KitKatFarrelly/LIDAR-Project-Hardware/README.md

# What is this??
This is the KiCAD files for the PCB and schematic of several iterations of my LIDAR sensor board.
The goal of this board is a wifi-enabled LIDAR sensor that also collects direction and acceleration data via IMU and can act as a flight controller.
