KitKatFarrelly/LIDAR-Project-Hardware/EPC611 LIDAR revision/Microlidar BOM For PCBWay.xlsx

Line Item | Component Type | Part | Manufacturer | Manufacturer PN | References | Quantity | Footprint | Type | Tolerance | Wattage | Voltage Rating | Generic OK? | Notes
1 | Capacitor | 1u Cap | Samsung | CL10B105KA8NNNC | C1,C7,C11,C17,C25 | 5 | 0603 | SMD |  |  | 25V | Yes
2 | Capacitor | 4.7u Cap | Murata | GRM188R61E475KE11D | C2,C3,C9,C10,C12,C14 | 6 | 0603 | SMD |  |  | 35V | Yes
3 | Capacitor | 10u Cap | Samsung | CL21X106KAYNNNE | C4,C33 | 2 | 0805 | SMD |  |  | 25V | Yes
4 | Capacitor | 100n Cap | Samsung | CL05B104KA5NNNC | C5,C6,C8,C18,C19,C20,C21,C22,C23,C24,C26,C27,C30,C31,C32,C35 | 16 | 0402 | SMD |  |  | 25V | Yes
5 | Capacitor | 166p Cap | Murata | GCM1555C1H161FA16D | C13 | 1 | 0402 | SMD |  |  | 50V | Yes
6 | Capacitor | 26p Cap | AVX Corporation | 04025A270JAT2A | C15 | 1 | 0402 | SMD |  |  | 50V | Yes
7 | Capacitor | 22u Cap | YAGEO | CC0805MKX5R8BB226 | C16 | 1 | 0805 | SMD |  |  | 25V | Yes
8 | Capacitor | 6p Cap | Samsung | CL05C060DB5NNNC | C28,C29 | 2 | 0402 | SMD |  |  | 50V | Yes
9 | Capacitor | 220n Cap | Murata | GRM155C8YA224KE01D | C34 | 1 | 0402 | SMD |  |  | 25V | Yes
10 | Diode | Schottky | Micro Commercial Co | BAS40-TP | D1,D2,D3 | 3 | SOT-23 | SMD
11 | Diode | LED | OSRAM | SFH 4718A | D4,D5 | 2 | 3-SMD | SMD
12 | Diode | Schottky | SMC Diode Solutions | DSS14UTR | D6 | 1 | SOD-123F | SMD
13 | Inductor | 33u Ind | Taiyo Yuden | CB2518T330K | L1 | 1 | 1008 | SMD
14 | Inductor | 1u Ind | TDK Corporation | MLZ1608A1R0WT000 | L2 | 1 | 0603 | SMD
15 | Connector | 4 pin Molex | Molex | 53261-0471 | J1,J2 | 2 | SMT 4P | SMD |  |  |  |  | DNP
16 | Connector | Micro B USB | Molex | 105017-0001 | J3 | 1 | MICRO B USB | SMD |  |  | 30V
17 | Connector | 8 pin Molex | Molex | 53261-0871 | J5 | 1 | SMT 8P | SMD |  |  |  |  | DNP
18 | Connector | 2 pin header | GCT | BC020-02-A-0200-0300-L-G | J6 | 1 | THRU 2P | Through Hole |  |  | 250V
19 | Transistor | NMOSFET | Nexperia USA Inc. | 2N7002P,215 | Q1 | 1 | SOT-23 | SMD
20 | Resistor | 1 Res | Stackpole Electronics | RNCP0805FTD1R00 | R1 | 1 | 0805 | SMD | 1% | 1/4 W |  | Yes
21 | Resistor | 3.3k Res | Panasonic | ERJ-2GEJ332X | R2 | 1 | 0402 | SMD | 1% | 1/10 W |  | Yes
22 | Resistor | 1k Res | YAGEO | RC0402FR-7W1KL | R3,R6,R8,R10,R18,R19 | 6 | 0402 | SMD | 1% | 1/8 W |  | Yes
23 | Resistor | 10k Res | YAGEO | AC0402FR-7W10KL | R4,R5,R15,R22 | 4 | 0402 | SMD | 1% | 1/8 W |  | Yes
24 | Resistor | 75k Res | Stackpole Electronics | RMCF0402FT75K0 | R7 | 1 | 0402 | SMD | 1% | 1/16 W |  | Yes
25 | Resistor | 82.5k Res | Samsung | RC1005F8252CS | R9 | 1 | 0402 | SMD | 1% | 1/16 W |  | Yes
26 | Resistor | 1.2k Res | Panasonic | ERJ-U02F1201X | R11 | 1 | 0402 | SMD | 1% | 1/10 W |  | Yes
27 | Resistor | 49.9 Res | YAGEO | AF0402FR-0749R9L | R12,R13,R14 | 3 | 0402 | SMD | 1% | 1/16 W |  | Yes
28 | Resistor | 27.4 Res | Panasonic | ERJ-2RKF27R4X | R16, R17 | 2 | 0402 | SMD | 1% | 1/16 W |  | Yes
29 | Resistor | Jumper | YAGEO | RC0805JR-070RL | R20 | 1 | 0805 | SMD | 1% | 1/10 W |  | Yes | DNP
30 | Resistor | 100k Res | YAGEO | RC0201JR-07100KL | R21 | 1 | 0201 | SMD | 1% | 1/20 W |  | Yes
31 | Integrated Circuit | Regulator | RICOH | R1283K001C | U1 | 1 | 12-UFDFN | SMD
32 | Integrated Circuit | LIDAR | ESPROS | EPC611 | U2 | 1 | 24-CSP | SMD
33 | Integrated Circuit | RP2040 | Raspberry Pi | SC0908(7) | U3 | 1 | 56-VFQFN | SMD
34 | Integrated Circuit | Flash | Winbond | W25Q32JVZPIQ | U4 | 1 | 8-WDFN | SMD
35 | Integrated Circuit | Regulator | Texas Instruments | TPSM828214SILR | U5 | 1 | 10-uSIP | SMD
36 | Integrated Circuit | IMU | STMicroelectronics | LSM303AGRTR | U6 | 1 | 12-VFLGA | SMD
37 | Oscillator | 4MHz | ECS Inc. | ECS-2333-040-BN-TR | Y1 | 1 | 4-SMD | SMD
38 | Oscillator | 12MHz | ECS Inc. | ECS-120-8-36B-CWY-TR | Y2 | 1 | 4-SMD | SMD
 | Generic OK: For Generic Components, the Footprint and Value must match. The Wattage or Voltage rating must match or be better than specified.
