KitKatFarrelly/LIDAR-Project-Hardware/EPC611 LIDAR revision/Microlidar BOM.xlsx

Component Type | Part | Manufacturer PN | References | Footprint | Wattage | Voltage Rating | Cost x1 | Cost x10 | Number Used | Cost per board for 1 board | Cost per board for 10 boards | Generic OK?
Capacitor | 1u Cap |  | C1,C7,C11,C17,C25 | 0603 |  | 16V | 0.1 | 0.035 | 5 | 0.5 | 0.175 | Yes
Capacitor | 4.7u Cap |  | C2,C3,C9,C10,C12,C14 | 0603 |  | 16V | 0.11 | 0.081 | 6 | 0.66 | 0.486 | Yes
Capacitor | 10u Cap |  | C4,C33 | 0805 |  | 16V | 0.11 | 0.083 | 2 | 0.22 | 0.166 | Yes
Capacitor | 100n Cap |  | C5,C6,C8,C18,C19,C20,C21,C22,C23,C24,C26,C27,C30,C31,C32,C35 | 0402 |  | 16V | 0.1 | 0.019 | 16 | 1.6 | 0.304 | Yes
Capacitor | 166p Cap |  | C13 | 0402 |  | 16V | 0.1 | 0.044 | 1 | 0.1 | 0.044 | Yes
Capacitor | 26p Cap |  | C15 | 0402 |  | 16V | 0.1 | 0.035 | 1 | 0.1 | 0.035 | Yes
Capacitor | 22u Cap |  | C16 | 0805 |  | 16V | 0.34 | 0.235 | 1 | 0.34 | 0.235 | Yes
Capacitor | 6p Cap |  | C28,C29 | 0402 |  | 16V | 0.1 | 0.038 | 2 | 0.2 | 0.076 | Yes
Capacitor | 220n Cap |  | C34 | 0402 |  | 16V | 0.14 | 0.101 | 1 | 0.14 | 0.101 | Yes
Diode | Schottky | BAS40-TP | D1,D2,D3 | SOT-23 |  |  | 0.24 | 0.162 | 3 | 0.72 | 0.486
Diode | LED | SFH 4718A | D4,D5 |  |  |  | 2.23 | 1.487 | 2 | 4.46 | 2.974
Diode | Schottky | DSS14UTR | D6 | SOD-123F |  |  | 0.23 | 0.189 | 1 | 0.23 | 0.189
Inductor | 33u Ind | CB2518T330K | L1 | 1008 |  |  | 0.17 | 0.152 | 1 | 0.17 | 0.152
Inductor | 1u Ind | MLZ1608A1R0WT000 | L2 | 0603 |  |  | 0.15 | 0.135 | 1 | 0.15 | 0.135
Connector | 4 pin Molex | 53261-0471 | J1,J2 |  |  |  | 0.59 | 0.499 | 2 | 1.18 | 0.998
Connector | Micro B USB | 105017-0001 | J3 |  |  | 30V | 0.96 | 0.794 | 1 | 0.96 | 0.794
Connector | 8 pin Molex | 53261-0871 | J5 |  |  |  | 0.76 | 0.631 | 1 | 0.76 | 0.631
Connector | 2 pin header | BC020-02-A-0200-0300-L-G | J6 |  |  | 250V | 0.5 | 0.427 | 1 | 0.5 | 0.427
Transistor | NMOSFET | 2N7002P,215 | Q1 | SOT-23 |  |  | 0.17 | 0.117 | 1 | 0.17 | 0.117
Resistor | 1 Res |  | R1 | 0805 | 1/4 W |  | 0.1 | 0.073 | 1 | 0.1 | 0.073 | Yes
Resistor | 3.3k Res |  | R2 | 0402 | 1/10 W |  | 0.1 | 0.021 | 1 | 0.1 | 0.021 | Yes
Resistor | 1k Res |  | R3,R6,R8,R10,R18,R19 | 0402 | 1/10 W |  | 0.1 | 0.072 | 6 | 0.6 | 0.432 | Yes
Resistor | 10k Res |  | R4,R5,R15,R22 | 0402 | 1/20 W |  | 0.1 | 0.01 | 4 | 0.4 | 0.04 | Yes
Resistor | 75k Res |  | R7 | 0402 | 1/20 W |  | 0.1 | 0.014 | 1 | 0.1 | 0.014 | Yes
Resistor | 83k Res |  | R9 | 0402 | 1/20 W |  | 0.1 | 0.014 | 1 | 0.1 | 0.014 | Yes
Resistor | 1.2k Res |  | R11 | 0402 | 1/10 W |  | 0.14 | 0.114 | 1 | 0.14 | 0.114 | Yes
Resistor | 49.9 Res |  | R12,R13,R14 | 0402 | 1/16 W |  | 0.1 | 0.015 | 3 | 0.3 | 0.045 | Yes
Resistor | 27.4 Res |  | R16, R17 | 0402 | 1/16 W |  | 0.1 | 0.015 | 2 | 0.2 | 0.03 | Yes
Resistor | Jumper |  | R20 | 0805 | 1/4 W |  | 0.14 | 0.124 | 1 | 0.14 | 0.124 | Yes
Resistor | 100k Res |  | R21 | 0201 | 1/20 W |  | 0.1 | 0.029 | 1 | 0.1 | 0.029 | Yes
Integrated Circuit | Regulator | R1283K001C | U1 |  |  |  | 2.12 | 1.908 | 1 | 2.12 | 1.908
Integrated Circuit | LIDAR | EPC611 | U2 |  |  |  | 11.4 | 9 | 1 | 11.4 | 9
Integrated Circuit | RP2040 | SC0908(7) | U3 |  |  |  | 1 | 1 | 1 | 1 | 1
Integrated Circuit | Flash | W25Q32JVZPIQ | U4 |  |  |  | 1.01 | 0.921 | 1 | 1.01 | 0.921
Integrated Circuit | Regulator | TPSM828214SILR | U5 |  |  |  | 2.96 | 2.655 | 1 | 2.96 | 2.655
Integrated Circuit | IMU | LSM303AGRTR | U6 |  |  |  | 5.56 | 4.998 | 1 | 5.56 | 4.998
Oscillator | 4MHz | ECS-2333-040-BN-TR | Y1 |  |  |  | 1.24 | 1.182 | 1 | 1.24 | 1.182
Oscillator | 12MHz | ECS-120-8-36B-CWY-TR | Y2 |  |  |  | 0.51 | 0.425 | 1 | 0.51 | 0.425
 |  |  |  |  |  |  |  |  | Total | 41.24 | 31.55
Generic OK: For Generic Components, the Footprint and Value must match. The Wattage or Voltage rating must match or be better than specified.
The cost calculation is only meant to be an estimate based on prices I found on Digikey.
