KitKatFarrelly/LIDAR-Project-Hardware/EPC611 LIDAR/Microlidar BOM.xlsx

Component Type | Part | Manufacturer PN | References | Cost x1 | Cost x10 | Cost x25 | Cost x50 | Number Used | Cost per board for 1 board | Cost per board for 10 boards | Link to part
Capacitor | 1u Cap | CL10A105KA8NNNC | C1,C7,C11 | 0.1 | 0.035 |  | 0.019 | 3 | 0.3 | 0.105 | https://www.digikey.com/en/products/detail/samsung-electro-mechanics/CL10A105KA8NNNC/3886760
Capacitor | 4.7u Cap | CL21A475KAQNNNE | C2,C3,C10,C12,C14,C17 | 0.11 | 0.081 |  | 0.046 | 6 | 0.66 | 0.276 | https://www.digikey.com/en/products/detail/samsung-electro-mechanics/CL21A475KAQNNNE/3886902
Capacitor | 10u Cap | CL21A106KOQNNNG | C4,C18 | 0.11 | 0.083 |  | 0.045 | 2 | 0.22 | 0.166 | https://www.digikey.com/en/products/detail/samsung-electro-mechanics/CL21A106KOQNNNG/3894417
Capacitor | 100n Cap | CL05B104KA5NNNC | C5,C6,C8,C9,C16,C20 | 0.1 | 0.019 |  | 0.0106 | 6 | 0.6 | 0.0636 | https://www.digikey.com/en/products/detail/samsung-electro-mechanics/CL05B104KA5NNNC/5961204
Capacitor | 166p Cap | CL10C161JB8NNNC | C13 | 0.1 | 0.044 |  | 0.0242 | 1 | 0.1 | 0.044 | https://www.digikey.com/en/products/detail/samsung-electro-mechanics/CL10C161JB8NNNC/3887863
Capacitor | 26p Cap | CL05C270JB5NNNC | C15 | 0.1 | 0.035 |  | 0.019 | 1 | 0.1 | 0.035 | https://www.digikey.com/en/products/detail/samsung-electro-mechanics/CL05C270JB5NNNC/3886811
Capacitor | 22u Cap | CL21A226MOCLRNC | C19 | 0.34 | 0.235 |  | 0.1564 | 1 | 0.34 | 0.235 | https://www.digikey.com/en/products/detail/samsung-electro-mechanics/CL21A226MOCLRNC/5961264
Diode | Schottky | BAS40-TP | D1,D2,D3 | 0.24 | 0.162 | 0.162 |  | 3 | 0.72 | 0.486 | https://www.digikey.com/en/products/detail/micro-commercial-co/BAS40-TP/717216
Diode | LED | SFH_4555 | D4 | 0.72 | 0.47 | 0.47 |  | 1 | 0.72 | 0.47 | https://www.digikey.com/en/products/detail/osram-opto-semiconductors-inc/SFH-4555/2205957
Inductor | 33u Ind | CB2518T330K | L1 | 0.17 | 0.152 | 0.136 |  | 1 | 0.17 | 0.152 | https://www.digikey.com/en/products/detail/taiyo-yuden/CB2518T330K/2763290
Inductor | 1u Ind | MLZ1608A1R0WT000 | L2 | 0.15 | 0.135 | 0.12 |  | 1 | 0.15 | 0.135 | https://www.digikey.com/en/products/detail/tdk-corporation/MLZ1608A1R0WT000/2465143
Inductor | 3.9u Ind | SRN6028-3R9M | L3 | 0.44 | 0.385 | 0.3576 |  | 1 | 0.44 | 0.385 | https://www.digikey.com/en/products/detail/bourns-inc/SRN6028-3R9M/4867726
Integrated Circuit | Regulator | R1283K001C | U1 | 2.12 | 1.908 | 1.8 |  | 1 | 2.12 | 1.908 | https://www.digikey.com/en/products/detail/ricoh-electronic-devices-co-ltd/R1283K001C-TR/10212797
Integrated Circuit | LIDAR | EPC611 | U2 | 11.4 | 9 | 8 |  | 1 | 11.4 | 9 | https://www.digikey.com/en/products/detail/espros-photonics-ag/EPC611-CSP24-001/10516869
Integrated Circuit | uC | STM32G030K8T6 | U3 | 1.79 | 1.601 | 1.5196 |  | 1 | 1.79 | 1.601 | https://www.digikey.com/en/products/detail/stmicroelectronics/STM32G030K8T6/10326689
Integrated Circuit | Oscillator | DSC6001CI2A-004.0000 | U4 | 0.9 | 0.9 | 0.75 |  | 1 | 0.9 | 0.9 | https://www.digikey.com/en/products/detail/microchip-technology/DSC6001CI2A-004-0000/6244461
Integrated Circuit | Regulator | AP63203WU-7 | U5 | 0.83 | 0.738 | 0.7 |  | 1 | 0.83 | 0.738 | https://www.digikey.com/en/products/detail/diodes-incorporated/AP63203WU-7/9858426
Transistor | NMOSFET | 2N7002P,215 | Q1 | 0.17 | 0.117 | 0.112 |  | 1 | 0.17 | 0.117 | https://www.digikey.com/en/products/detail/nexperia-usa-inc/2N7002P215/2296323
Switch | Pushbutton | PTS647SM38SMTR2LFS | SW1 | 0.13 | 0.127 | 0.1208 |  | 1 | 0.13 | 0.127 | https://www.digikey.com/en/products/detail/c-k/PTS-647-SM38-SMTR2-LFS/9649861
Resistor | 3 Res | RMCF1210JT3R00 | R1 | 0.1 | 0.091 | 0.091 |  | 1 | 0.1 | 0.091 | https://www.digikey.com/en/products/detail/stackpole-electronics-inc/RMCF1210JT3R00/1757302
Resistor | 3.3k Res | RC0603FR-073K3L | R2 | 0.1 | 0.021 | 0.021 |  | 1 | 0.1 | 0.021 | https://www.digikey.com/en/products/detail/yageo/RC0603FR-073K3L/727126
Resistor | 1k Res | ESR03EZPJ102 | R3,R4,R5.R6,R8,R10 | 0.1 | 0.072 | 0.072 |  | 6 | 0.6 | 0.432 | https://www.digikey.com/en/products/detail/rohm-semiconductor/ESR03EZPJ102/1762721
Resistor | 75k Res | RC0402FR-0775KL | R7 | 0.1 | 0.014 | 0.014 |  | 1 | 0.1 | 0.014 | https://www.digikey.com/en/products/detail/yageo/RC0402FR-0775KL/2827576
Resistor | 83k Res | RC0402FR-0782K5L | R9 | 0.1 | 0.014 | 0.014 |  | 1 | 0.1 | 0.014 | https://www.digikey.com/en/products/detail/yageo/RC0402FR-0782K5L/726666
Resistor | 1.2k Res | CRGP0603F1K2 | R11 | 0.14 | 0.114 | 0.114 |  | 1 | 0.14 | 0.114 | https://www.digikey.com/en/products/detail/te-connectivity-passive-product/CRGP0603F1K2/8577019
 |  |  |  |  |  |  |  | Total | 23 | 17.6296
