KitKatFarrelly/LIDAR-Project-Hardware/kicad-esp32-pcb.FCStd

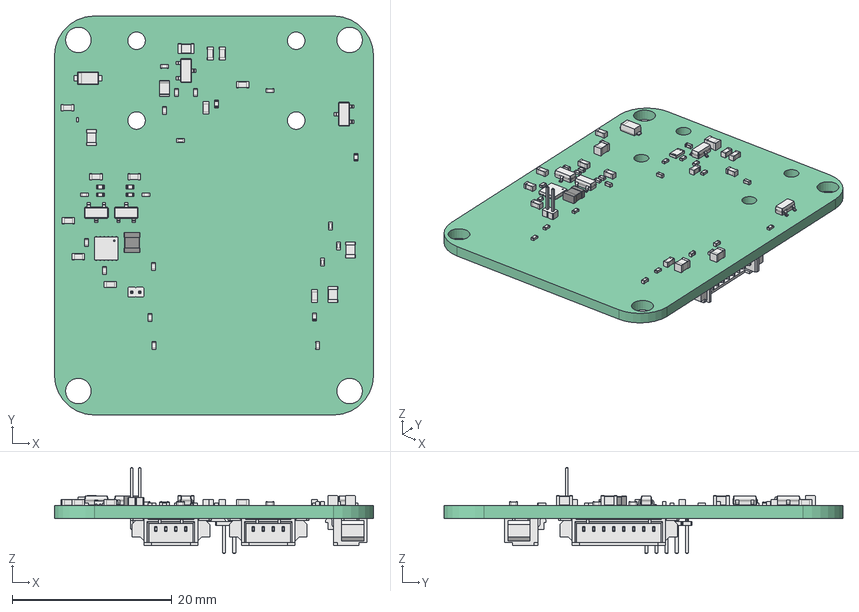
[picture p1: CAD file, 2022-10-16]
kicad-esp32-pcb.FCStd
40.0 x 50.0 x 10.8 mm
Pcb_f832
J6_PinHeader_1x02_P100mm_Vertical_61293A53
R17_R_0402_1005Metric_61293C5A
R14_R_0402_1005Metric_61293C2D
R13_R_0402_1005Metric_61293C1E
C23_C_0603_1608Metric_612937A6
C18_C_0402_1005Metric_6129375B
C17_C_0805_2012Metric_6129374C
D6_D_SOD_123F_6.1283e+99
R16_R_0201_0603Metric_6114ADB6
U1_DFN_12_1EP_3x3mm_P05mm_EP205x286mm_6114AE0D
R15_R_0402_1005Metric_6114ADC5
R12_R_0402_1005Metric_6114AD2D
R11_R_0402_1005Metric_6114AD1E
R10_R_0402_1005Metric_6114AD0F
R9_R_0402_1005Metric_6114AD00
R8_R_0402_1005Metric_6114ACF1
R7_R_0402_1005Metric_6114ACE2
R6_R_0402_1005Metric_6114ACD3
R5_R_0402_1005Metric_6114ACC4
R4_R_0402_1005Metric_6114ACB5
R3_R_0402_1005Metric_6114ACA6
R2_R_0402_1005Metric_6114AC97
R1_R_0805_2012Metric_6114AC88
Q1_SOT_23_6114AC77
L2_L_0603_1608Metric_6114AC62
L1_L_1008_2520Metric_6114AC51
D3_D_SOT_23_6114AAFF
D2_D_SOT_23_6114AAE5
D1_D_SOT_23_6114AACB
C22_C_0402_1005Metric_6114AAB1
C21_C_0805_2012Metric_6114AAA2
C20_C_0402_1005Metric_6114AA91
C19_C_0402_1005Metric_6114AA82
C16_C_0805_2012Metric_6114A99D
C15_C_0402_1005Metric_6114A98C
C14_C_0603_1608Metric_6114A97D
C13_C_0402_1005Metric_6114A96C
C12_C_0603_1608Metric_6114A95D
C11_C_0603_1608Metric_6114A94C
C10_C_0603_1608Metric_6114A93B
C9_C_0603_1608Metric_6114A92A
C8_C_0402_1005Metric_6114A919
C7_C_0603_1608Metric_6114A90A
C6_C_0402_1005Metric_6114A8F9
C5_C_0402_1005Metric_6114A8EA
C4_C_0805_2012Metric_6114A8DB
C3_C_0603_1608Metric_6114A8CA
C2_C_0603_1608Metric_6114A8B9
C1_C_0603_1608Metric_6114A8A8
J5_Molex_53261_0871_61293A3B
J3_Molex_53261_0471_612939FE
J1_PinHeader_2x05_P127mm_Vertical_SMD_61293985
J2_Molex_53261_0471_6114ABC9
