KitKatFarrelly/LIDAR-Project-Hardware/(list of files, cad)

Other CAD files:
EPC611 LIDAR ESP32/microlidar/EPC611 LIDAR-B_SilkS.dxf
EPC611 LIDAR ESP32/microlidar/EPC611 LIDAR-F_SilkS.dxf
