KitKatFarrelly/LIDAR-Project-Hardware/EPC611 LIDAR ESP32/EPC611 LIDAR.kicad_pcb

## KiCad design EPC611 LIDAR ESP32/EPC611 LIDAR.kicad_pcb (2022-10-16)

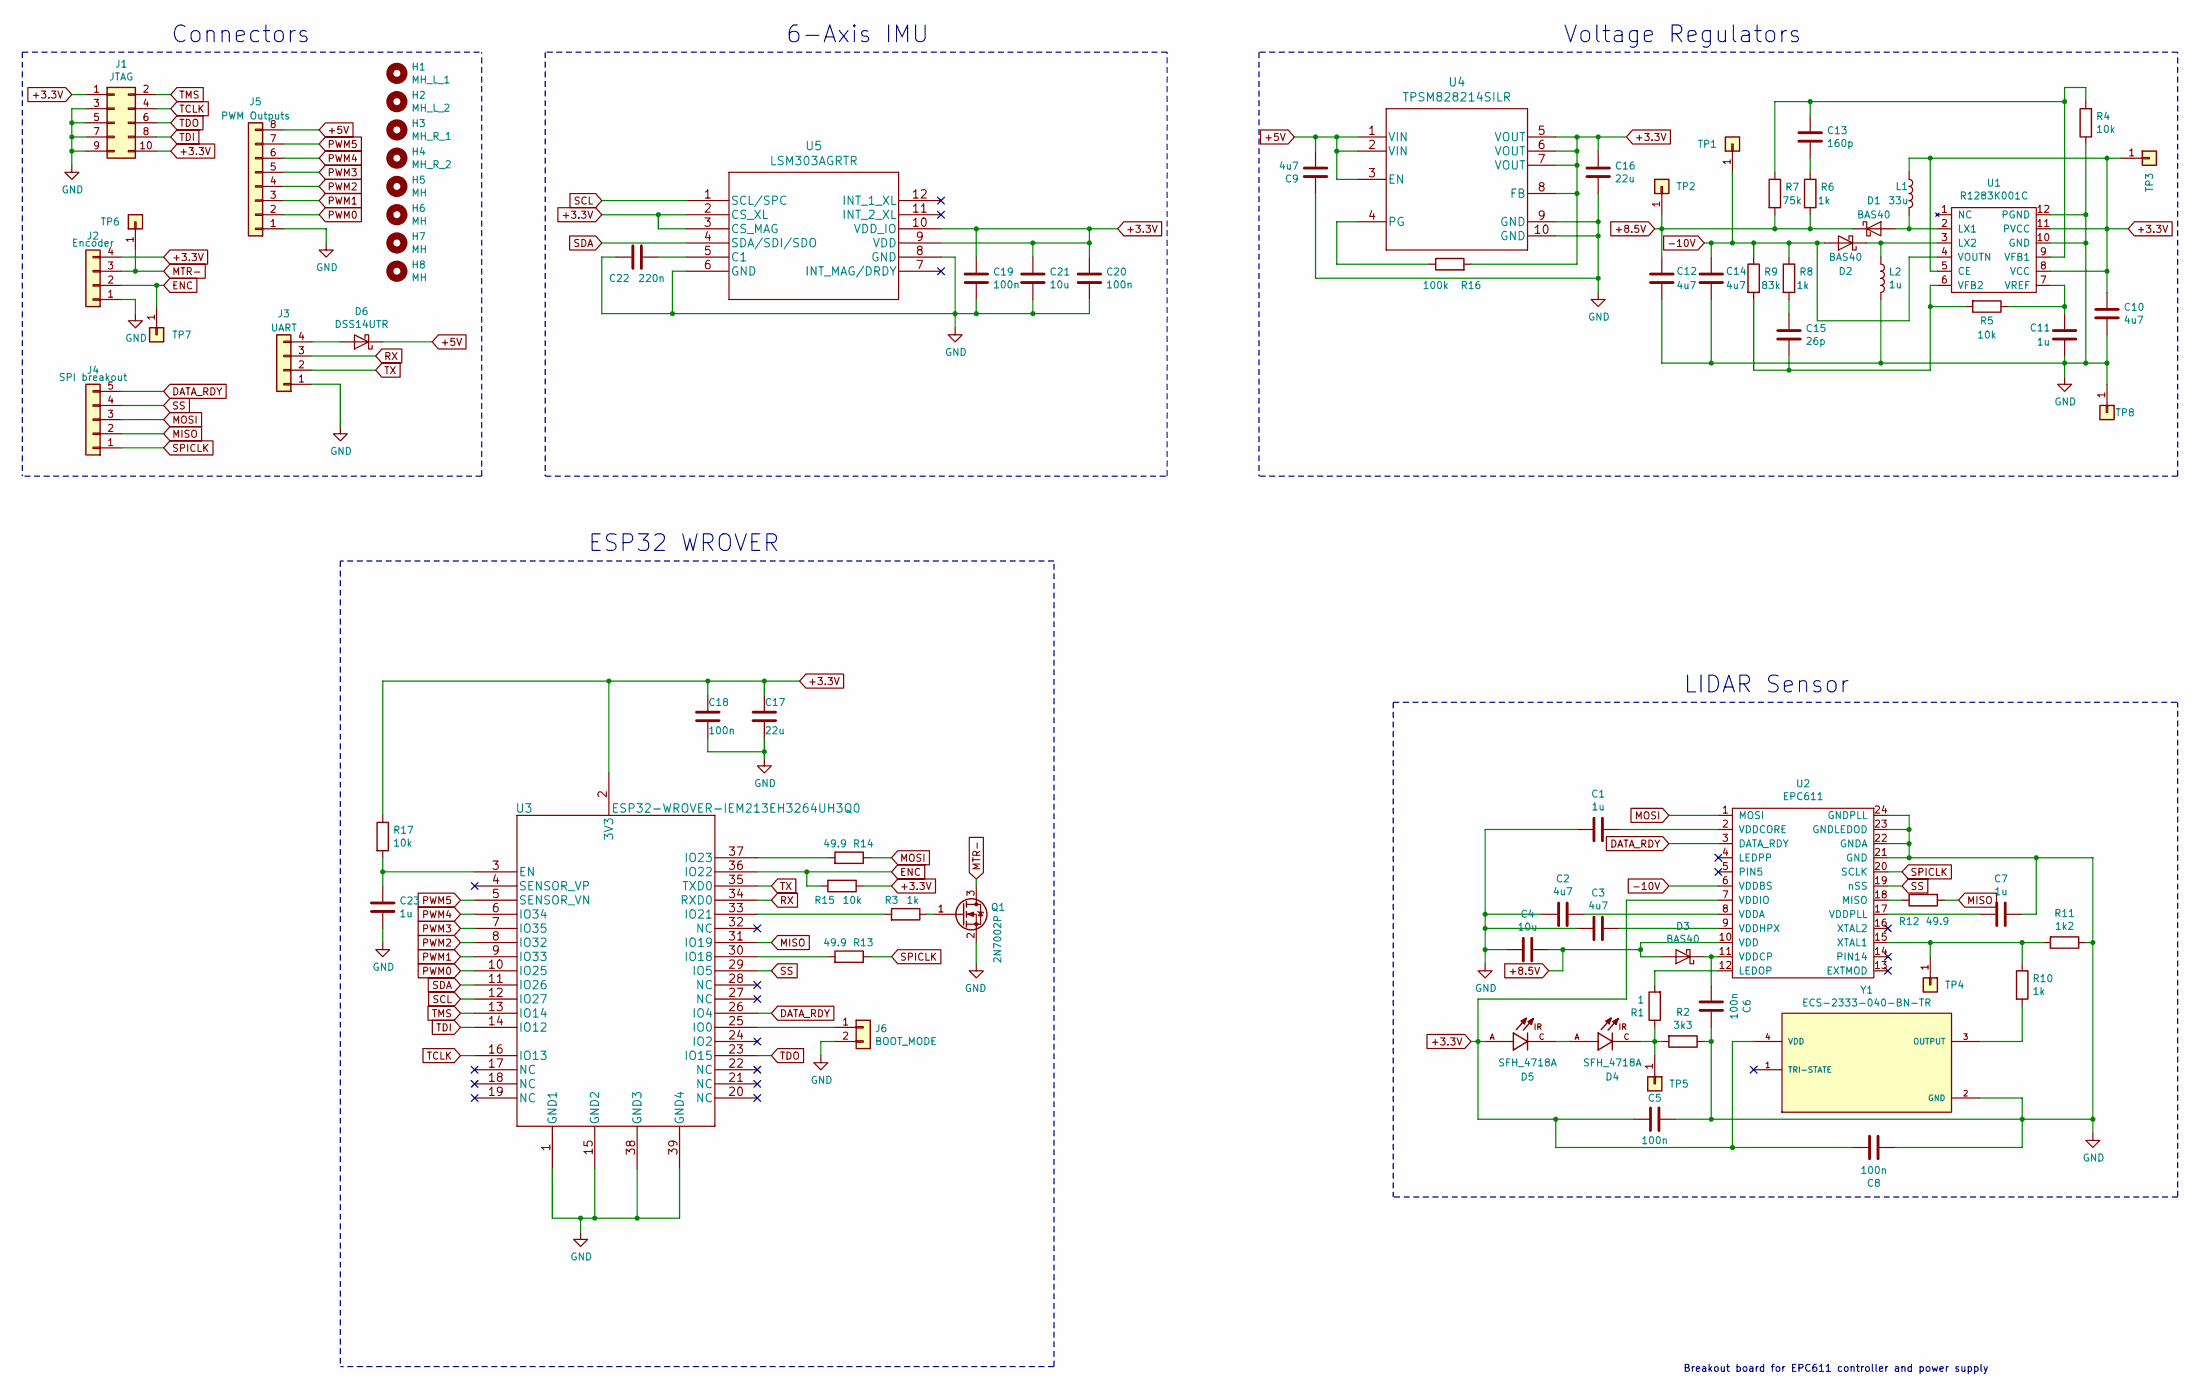
[picture p2: schematic EPC611 LIDAR.sch]

Parts:
C1, C7, C11, C23: 1u; C_0603_1608Metric
C2, C3, C9, C10, C12, C14: 4u7; C_0603_1608Metric
C4, C21: 10u; C_0805_2012Metric
C5, C6, C8, C18, C19, C20: 100n; C_0402_1005Metric
C13: 160p; C_0402_1005Metric
C15: 26p; C_0402_1005Metric
C16, C17: 22u; C_0805_2012Metric
C22: 220n; C_0402_1005Metric
D1, D2, D3: BAS40; D_SOT-23_ANK
D4, D5: SFH_4718A; LED_SFH_4718A; PARTREV 1.4
D6: DSS14UTR; D_SOD-123F
H1: MH_L_1; MountingHole_2.2mm_M2
H2: MH_L_2; MountingHole_2.2mm_M2
H3: MH_R_1; MountingHole_2.2mm_M2
H4: MH_R_2; MountingHole_2.2mm_M2
H5, H6, H7, H8: MH; MountingHole_3.2mm_M3
J1: JTAG; PinHeader_2x05_P1.27mm_Vertical_SMD
J2: Encoder; Molex_PicoBlade_53261-0471_1x04-1MP_P1.25mm_Horizontal
J3: UART; Molex_PicoBlade_53261-0471_1x04-1MP_P1.25mm_Horizontal
J4: SPI breakout; spi line debug
J5: PWM Outputs; Molex_PicoBlade_53261-0871_1x08-1MP_P1.25mm_Horizontal
J6: BOOT_MODE; PinHeader_1x02_P1.00mm_Vertical
L1: 33u; L_1008_2520Metric
L2: 1u; L_0603_1608Metric
Q1: 2N7002P; SOT-23
R1: 1; R_0805_2012Metric
R2: 3k3; R_0402_1005Metric
R3, R6, R8, R10: 1k; R_0402_1005Metric
R4, R5, R15, R17: 10k; R_0402_1005Metric
R7: 75k; R_0402_1005Metric
R9: 83k; R_0402_1005Metric
R11: 1k2; R_0402_1005Metric
R12, R13, R14: 49.9; R_0402_1005Metric
R16: 100k; R_0201_0603Metric
TP1, TP2, TP3, TP4, TP5, TP6, TP7, TP8: Conn_01x01; test point
U1: R1283K001C; R1283x
U2: EPC611
U3: ESP32-WROVER-IEM213EH3264UH3Q0
U4: TPSM828214SILR
U5: LSM303AGRTR
Y1: ECS-2333-040-BN-TR; OSC_ECS-2333-040-BN-TR; PARTREV N/A

Connections:
+3.3V: C5.2, C8.1, C10.1, C16.1, C17.1, C18.1, C19.1, C20.1, C21.1, D5.A, J1.1, J1.10, J2.4, L1.1, R15.1, R16.2, R17.1, TP3.1, U1.5 (CE), U1.8 (VCC), U1.11 (PVCC), U2.7 (VDDIO), U3.2 (3V3), U4.5 (VOUT), U4.6 (VOUT), U4.7 (VOUT), U4.8 (FB), U5.2 (CS_XL), U5.3 (CS_MAG), U5.9 (VDD), U5.10 (VDD_IO), Y1.4 (VDD)
+5V: C9.2, D6.1 (K), J5.8, U4.1 (VIN), U4.2 (VIN), U4.3 (EN)
+8.5V: C4.1, C12.1, D1.1 (K), D3.2 (A), R6.2, R7.2, TP2.1, U2.10 (VDD)
-10V: C14.1, D2.2 (A), R8.1, R9.1, TP1.1, U1.4 (VOUTN), U2.6 (VDDBS)
DATA_RDY: J4.5, U2.3 (DATA_RDY), U3.26 (IO4)
ENC: J2.2, R15.2, TP7.1, U3.36 (IO22)
GND: C1.2, C2.2, C3.2, C4.2, C5.1, C6.1, C7.1, C8.2, C9.1, C10.2, C11.2, C12.2, C14.2, C16.2, C17.2, C18.2, C19.2, C20.2, C21.2, C22.1, C23.2, J1.3, J1.5, J1.7, J1.9, J2.1, J3.1, J5.1, J6.2, L2.2, Q1.2 (S), R2.1, R4.1, R11.1, TP8.1, U1.10 (GND), U1.12 (PGND), U2.21 (GND), U2.22 (GNDA), U2.23 (GNDLEDOD), U2.24 (GNDPLL), U3.1 (GND1), U3.15 (GND2), U3.38 (GND3), U3.39 (GND4), U4.9 (GND), U4.10 (GND), U5.6 (GND), U5.8 (GND), Y1.2 (GND)
MISO: J4.2, R12.2, U3.31 (IO19)
MOSI: J4.3, R14.1, U2.1 (MOSI)
MTR-: J2.3, Q1.3 (D), TP6.1
unnamed: C1.1, U2.2 (VDDCORE)
unnamed: C2.1, U2.8 (VDDA)
unnamed: C3.1, U2.9 (VDDHPX)
unnamed: C6.2, D3.1 (K), U2.11 (VDDCP)
unnamed: C7.2, U2.17 (VDDPLL)
unnamed: C11.1, R5.1, U1.7 (VREF)
unnamed: C13.1, R4.2, R7.1, U1.9 (VFB1)
unnamed: C13.2, R6.1
unnamed: C15.1, R8.2
unnamed: C15.2, R5.2, R9.2, U1.6 (VFB2)
unnamed: C22.2, U5.5 (C1)
unnamed: C23.1, R17.2, U3.3 (EN)
unnamed: D1.2 (A), L1.2, U1.2 (LX1)
unnamed: D2.1 (K), L2.1, U1.3 (LX2)
unnamed: D4.A, D5.C
unnamed: D4.C, R1.1, R2.2, TP5.1
unnamed: D6.2 (A), J3.4
unnamed: J6.1, U3.25 (IO0)
unnamed: Q1.1 (G), R3.1
unnamed: R1.2, U2.12 (LEDOP)
unnamed: R3.2, U3.33 (IO21)
unnamed: R10.1, R11.2, TP4.1, U2.15 (XTAL1)
unnamed: R10.2, Y1.3 (OUTPUT)
unnamed: R12.1, U2.18 (MISO)
unnamed: R13.2, U3.30 (IO18)
unnamed: R14.2, U3.37 (IO23)
unnamed: R16.1, U4.4 (PG)
PWM0: J5.2, U3.10 (IO25)
PWM1: J5.3, U3.9 (IO33)
PWM2: J5.4, U3.8 (IO32)
PWM3: J5.5, U3.7 (IO35)
PWM4: J5.6, U3.6 (IO34)
PWM5: J5.7, U3.5 (SENSOR_VN)
RX: J3.3, U3.34 (RXD0)
SCL: U3.12 (IO27), U5.1 (SCL/SPC)
SDA: U3.11 (IO26), U5.4 (SDA/SDI/SDO)
SPICLK: J4.1, R13.1, U2.20 (SCLK)
SS: J4.4, U2.19 (nSS), U3.29 (IO5)
TCLK: J1.4, U3.16 (IO13)
TDI: J1.8, U3.14 (IO12)
TDO: J1.6, U3.23 (IO15)
TMS: J1.2, U3.13 (IO14)
TX: J3.2, U3.35 (TXD0)

Notes on the sheet:
Breakout board for EPC611 controller and power supply
Voltage Regulators
LIDAR Sensor
ESP32 WROVER
Connectors
6-Axis IMU

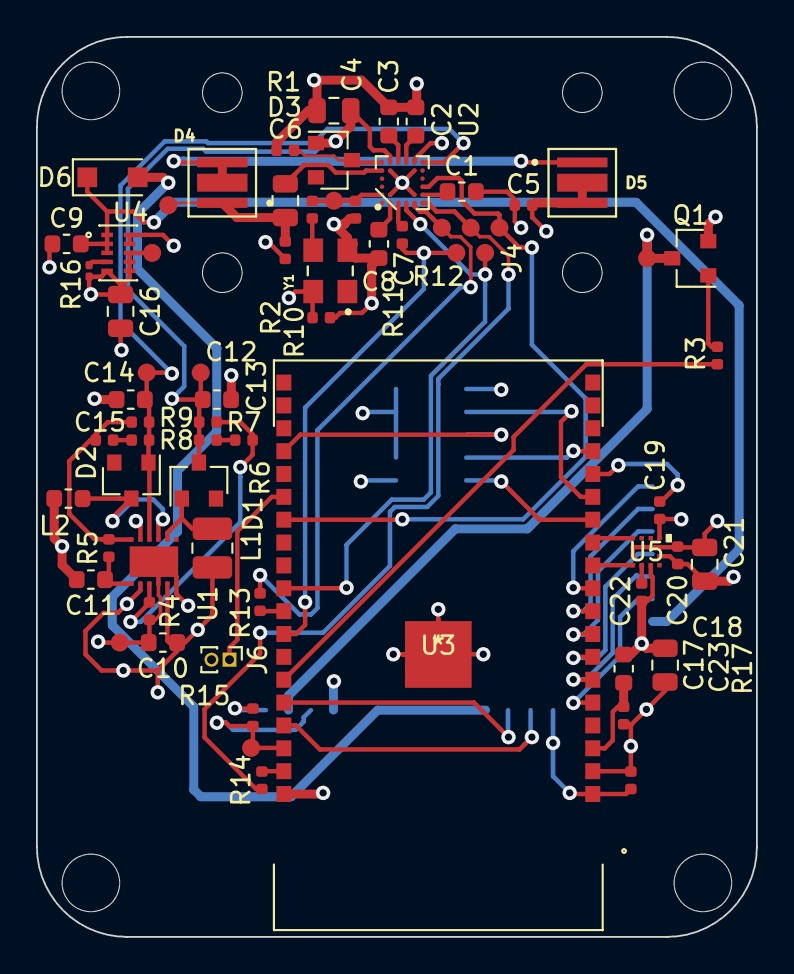
[picture p3: board EPC611 LIDAR.kicad_pcb from above]

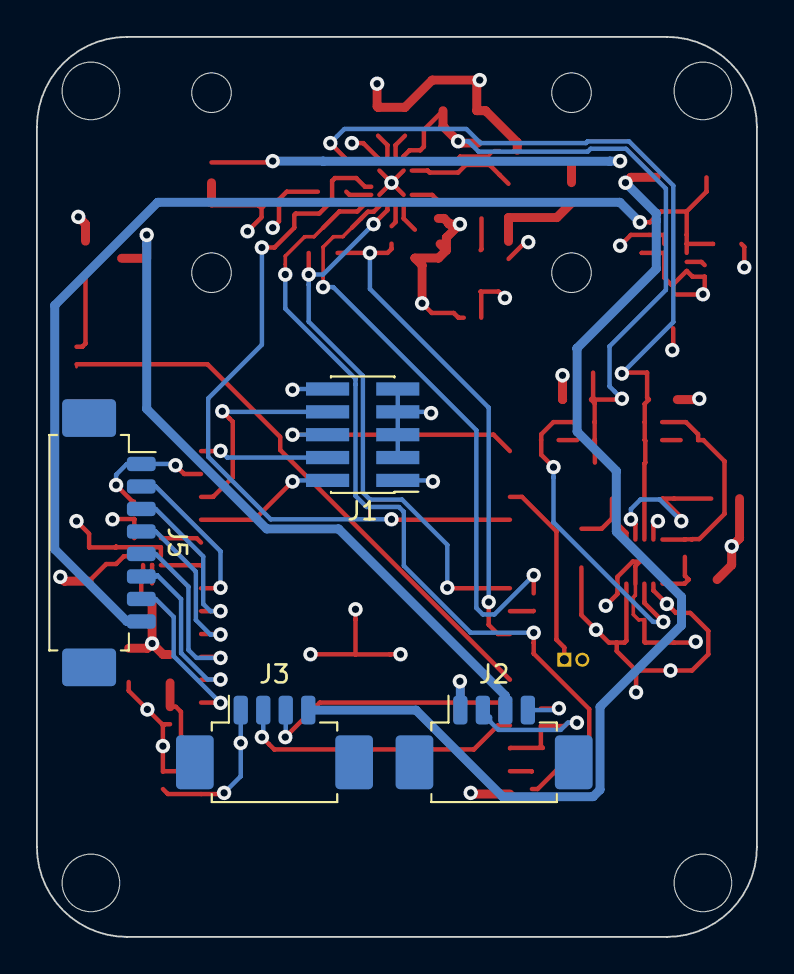
[picture p4: board EPC611 LIDAR.kicad_pcb from below]

Board: 4 copper layers, 40.0 x 50.0 mm, 77 parts (4 on the bottom side), 53 nets.
