KitKatFarrelly/LIDAR-Project-Hardware/(commit log)

2022-03-21 Initial Commit
    adding all the hardware files
    [EPC611 LIDAR-B_Cu.gbl, EPC611 LIDAR-B_Cu.gbr, EPC611 LIDAR-B_Mask.gbr, EPC611 LIDAR-B_Mask.gbs, EPC611 LIDAR-B_Paste.gbp, EPC611 LIDAR-B_Paste.gbr, EPC611 LIDAR-B_SilkS.gbo, EPC611 LIDAR-B_SilkS.gbr]
2022-10-16 added some 3D models
    [EPC611 LIDAR-B_SilkS.dxf, EPC611 LIDAR-F_SilkS.dxf, EPC611 LIDAR.kicad_pcb, kicad-esp32-pcb.FCStd]
